OgunAltun/KOM-19/FinalReport/PCB_3D/PCB1.png

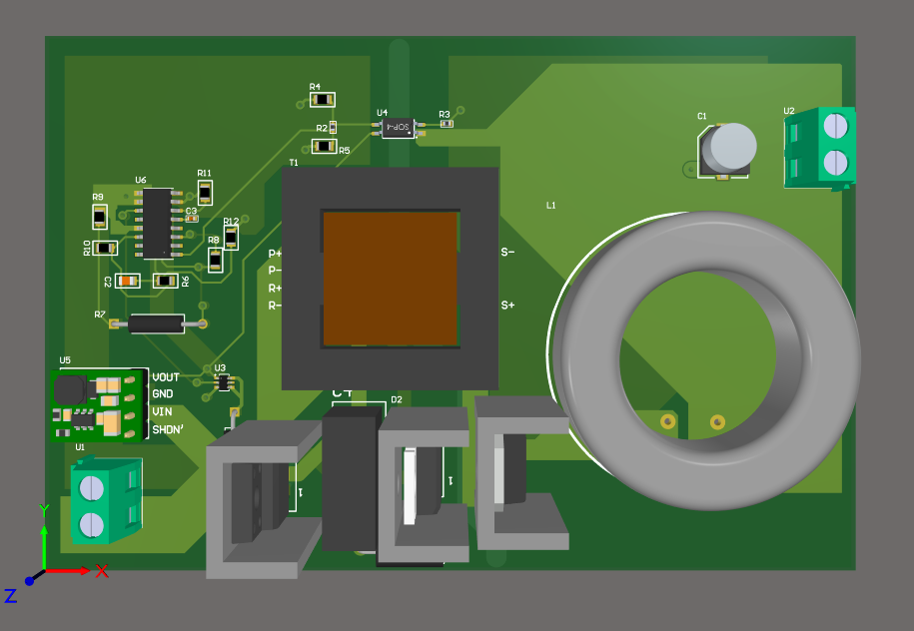
FinalReport/PCB_3D/PCB1.png
