OgunAltun/KOM-19/README.md

# KOM-19

EE464 Hardware Project

Project No: FOR#2

## Group Members

- Kutay Delibaş
- Ogün Altun
- Mehmet Gürtekin
