OgunAltun/KOM-19/Figures/Vout for 24Vi.png

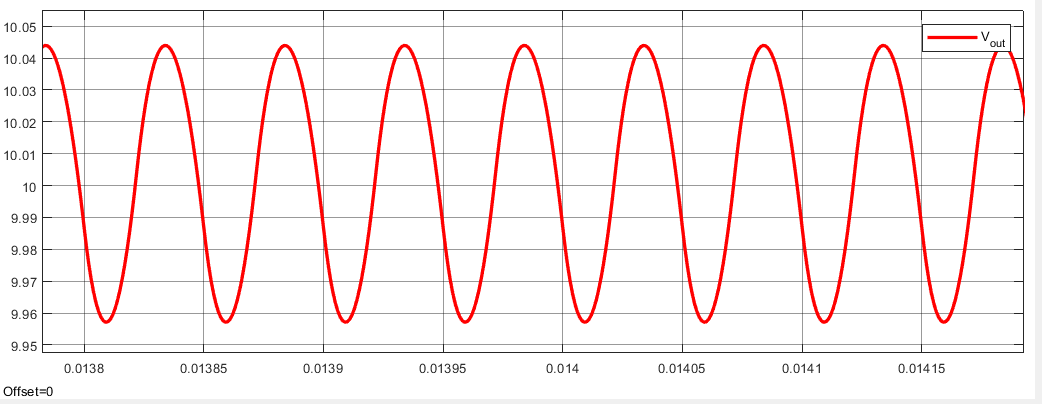
Figures/Vout for 24Vi.png
