OgunAltun/KOM-19/FinalReport/PCB_Layout/PCB_layout.png

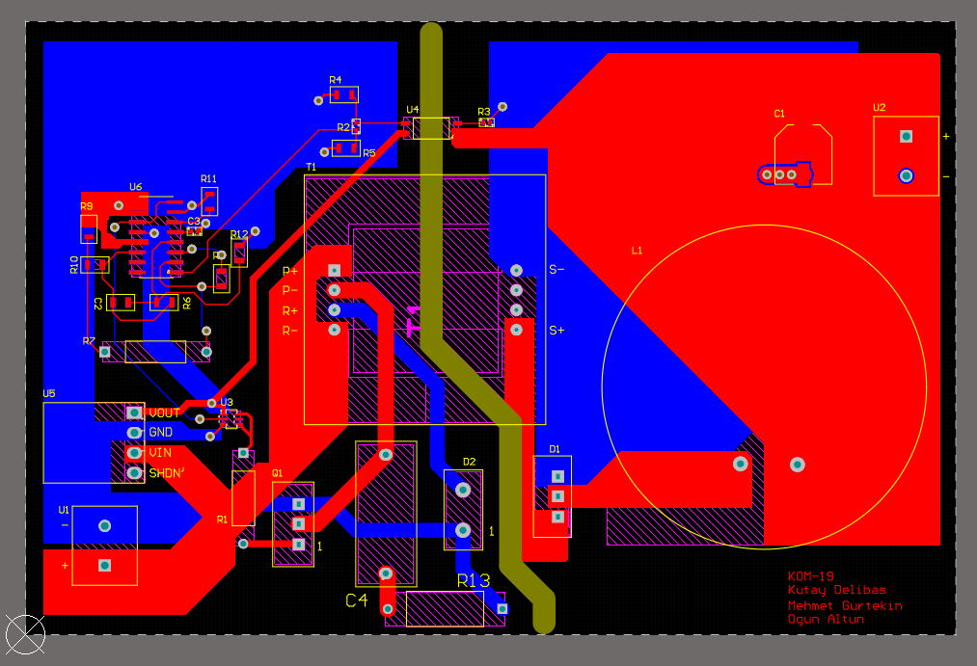
FinalReport/PCB_Layout/PCB_layout.png
