OgunAltun/KOM-19/FinalReport/PCB_Layout/PCB_layout_BOTTOM.png

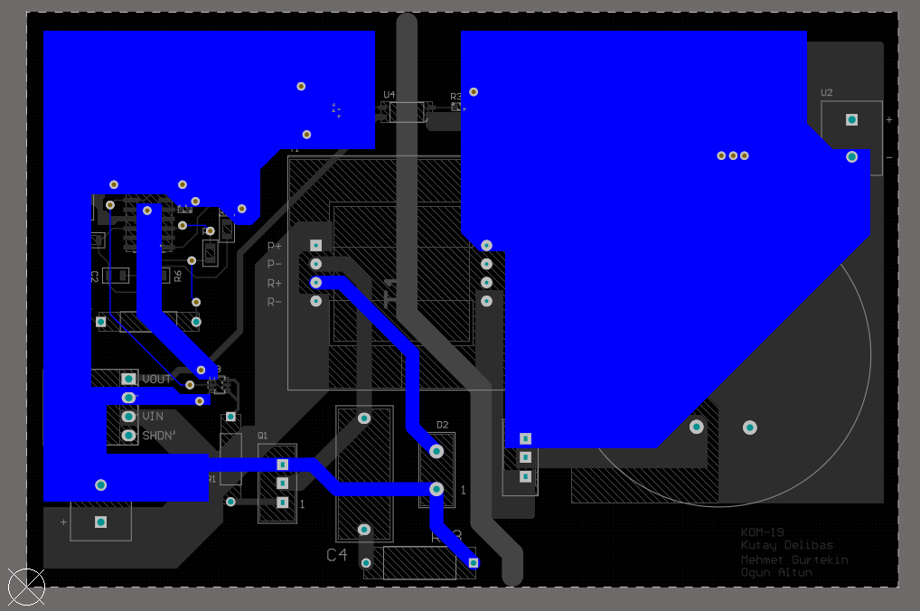
FinalReport/PCB_Layout/PCB_layout_BOTTOM.png
