OgunAltun/KOM-19/FinalReport/PCB_Layout/PCB_layout_TOP.png

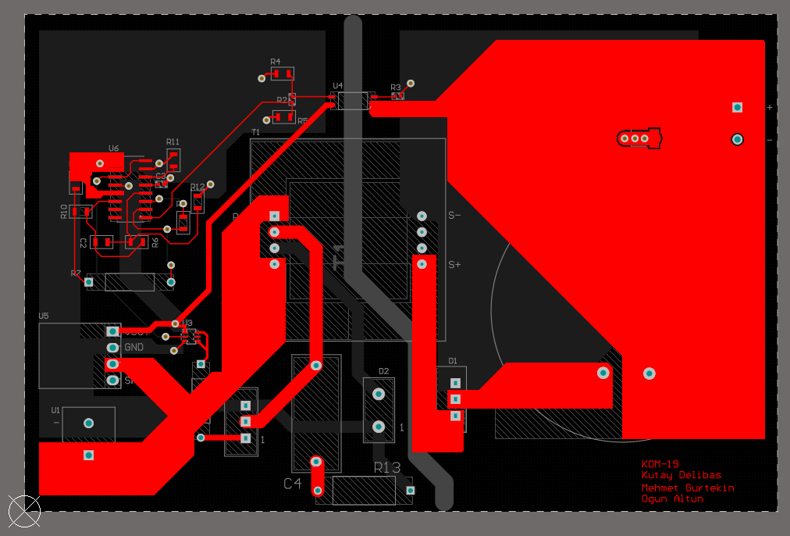
FinalReport/PCB_Layout/PCB_layout_TOP.png
