OgunAltun/KOM-19/FinalReport/Bill of Materials.xlsx

Comment | Description | Designator | Digikey Part Number | Quantity | Price $
33uF | Panasonic Aluminium Electrolytic Capacitor 100F 25 V dc 6.3mm Surface Mount D series FT SMD lifetime 2000h | C1 | EEE-FT1E101AP | 1 | 0.64
22uF | CAP CER 22UF 6.3V X5R 0805 | C2 | CL21A226KQCLRNC | 1 | 0.19
1nF | KEMET - SMD Multilayer Ceramic Capacitor, 1000 pF, 16 V, 0402 [1005 Metric], ± 10%, X7R, C Series KEMET | C3 | C0402C102K4RACTU | 1 | 0.10
1uF | PANASONIC ELECTRONIC COMPONENTS - ECWFE2W105K - CAP, 1µF, 450V, 10%, PP | C4 | ECWFE2W105K | 1 | 0.63
Diode Array | 2-Diode Schottky 100V 10A Through Hole TO-220AB | D1 | TST20U100CC0G | 1 | 0.96
8TQ100 | 8A, 100V, TO-220AC, Schottky Rect | D2 | 8TQ100 | 1 | 0.76
500uH | Kool Mu - 90 Toroid 500uH | L1 | - | 1 | 10.00
IRLS640A | Fairchild Semiconductor IRLS640A, MOSFET | Q1 | IRLS640A | 1 | 1.5
10Ohm | RES 10 OHM 1/4W 5% AXIAL | R1 | CF14JT10R0 | 1 | 0.10
15kOhm | TE CONNECTIVITY - SMD Chip Resistor, 0402 [1005 Metric], 15 kohm, CRGCQ Series, 50 V, Thick Film, 63 mW | R2 | CRGCQ0402F15K | 1 | 0.10
1.8kOhm | Res Thick Film 0402 1.8K Ohm 1% 0.063W(1/16W) ±100ppm/C Pad SMD Automotive T/R | R3 | CRGCQ0402F1K8 | 1 | 0.10
1kOhm | YAGEO (PHYCOMP) - RC0805JR-071KL - RES, THICK FILM, 1K, 5%, 0.125W, 0805 | R4, R9, R10, R12 | RC0805JR-071KL | 4 | 0.40
5kOhm | Res SMD 5K Ohm 5% 1/8W 0805 | R5, R8 | CRCW08055K00JNTA | 2 | 0.24
2.2kOhm | RESISTOR, THICK FILM, 2.2KOHM, 125mW, 1%, FULL REEL | R6 | RC0805FR-072K2L | 1 | 0.10
500 Ohm | RES 500 OHM 1/2W 1% AXIAL | R7 | CMF55500R00FKEB | 1 | 0.58
25kOhm | Cpf A 0805 25K 0.1% 25PPM 5K Rl | R11 | 5-2176238-6 | 1 | 0.57
1kOhm | 1kOhm 3W Through Hole | R13 | FMP200JR-52-1K | 1 | 0.34
Transformer | 3 Windings Transformer | T1 | - | 1 | 1.00
PowerConnector | TERM BLK 2POS SIDE ENTRY 5MM PCB | U1, U2 | 282836-2 | 2 | 1.42
Gate Driver | IC GATE DRVR IGBT/MOSFET SOT363 | U3 | ZXGD3009DYTA | 1 | 0.41
TLP291 | Transistor Output Optocouplers 50mA 80V Gen Purp 50mA 1 Circuit | U4 | TLP291(GB-TP,SE | 1 | 0.09
20/40V-15V Buck | DC DC Converter 15V 9W | U5 | 3797 | 1 | 4.95
TL494IDR | TEXAS INSTRUMENTS TL494IDR PWM Controller, 40V-7V supply, 300 kHz, 40V/200mA out, SOIC-16 | U6 | TL494IDR | 1 | 0.39
HeatSink1 | TO-220 Heatsink |  | V5274B-T | 1 | 0.55
HeatSink2 | TO-220 Heatsink |  | HSE-B1711-032 | 2 | 0.56
 |  |  |  | Component Price | 26.68
 |  |  |  | PCBWay (1 of 1000) | 1.13
 |  |  |  | TOTAL Price | 27.81
