OgunAltun/KOM-19/Forward.asc

C1: cap; 1µ
C2: cap; 33µ; Rser=1m
Cc1: cap; 19.5n
Cc2: cap; 1n
Cf3: cap; 2.2n
D1: diode
D2: diode
D4: diode
D7: diode
L1: ind; 500µ; Rser=30m
L2: ind2; 5.12m
L3: ind2; 2m
L4: ind; 30µ
L5: ind2; 2m
L6: ind; 2m
M1: nmos; BSC12DN20NS3
M2: nmos; BSC12DN20NS3
R1: res; 20.83
R2: res; 1k
R4: res; 2.18
Rc1: res; 8.8k
RC: res; 0.260
Rf1: res; 54.5k
Rf2: res; 5.4k
Rf3: res; 3.88k
RL: res; 36.83m
U1: UniversalOpamp2
U2: UniversalOpamp2
V1: voltage; PULSE(48 24 25m 0 0 10m 60m)
V2: voltage; PULSE(12 12 1 20n 20n 25m 50m)
Vosc: voltage; PULSE(0 1.8 0 25u 0 0 25u)
Vref: voltage; 0.9
Vv: voltage; 12
Named nets: 0, Vin, Vout, GateSignal
K L5 L3 L2 1
.tran 0.1
.model D D(Ron=0 Roff=1Meg Vfwd=0.7 Vrev=100)
