OgunAltun/KOM-19/(commit log)

2020-03-23 Output filter design
2020-05-23 Filter inductor is redesigned.
2020-05-25 Analog optocoupler, gate driver and buck converter selection.
2020-06-02 thermal design is done for mosfet
2020-06-03 thermal design is done for reset diode
2020-06-23 Controller design is revisited and circuit schematics are added to optocoupler, gate driver, buck converter and controller.
2020-06-23 PCB design files of the converter are added. Efficiency is reported.
    [Bill of Materials.xlsx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]
2020-06-24 Report parts are combined.
    [Bill of Materials.xlsx]
